grahamshaw1972/a2000Serotina/README.md

# A2000 Serotina Mechanical Keyboard

The A2000 Serotina Keyboard is a build it yourself Open Source Hardware Mechanical Keyboard for the Amiga A2000 and A3000 computers. Features are:

- Uses standard PC keyboard parts, case + keycaps

- Allows the use of the WASD keycap printing service for Amiga specific keycaps

- All soldering is Through Hole - no SMD soldering required

- No original A2000 keyboard parts required

- All electronic components are still available to buy

- Uses an Arduino micro-controller

- Uses Cherry MX type switches

- Uses QMK firmware ( with Amiga specific code added )

- Multiple QMK keymaps supported for regional key variations

- Plugs directly in to an A2000 or A3000 using the 5 pin Din connector - no USB required

Jan Beta has done an excellent build video for this keyboard. Please take a look:
https://youtu.be/dw3RDYq1Pn0?si=XJSP298tZxawzPFw

The keyboard layout for the UK keymap looks like this: 

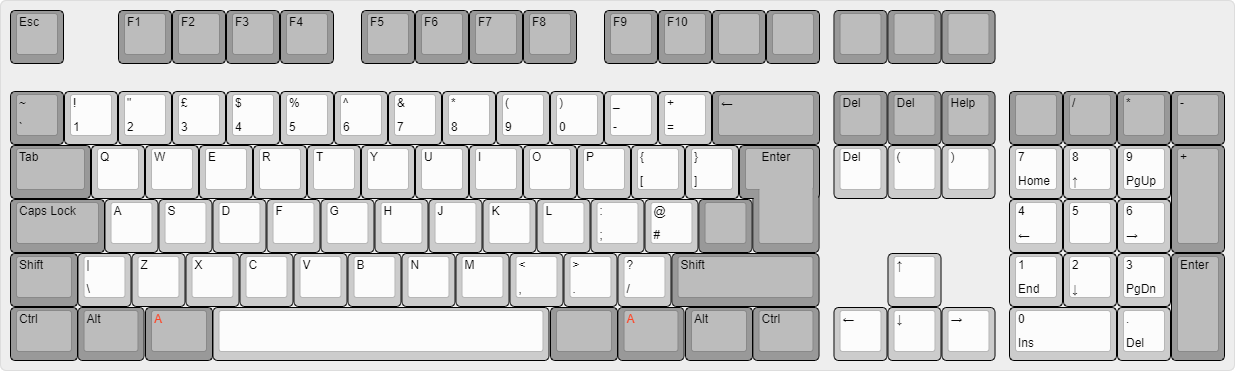
[picture p1: keyboardLayoutEditor/uk/a2000serotina_uk.png]


The PCB for V1.5 looks like this: 

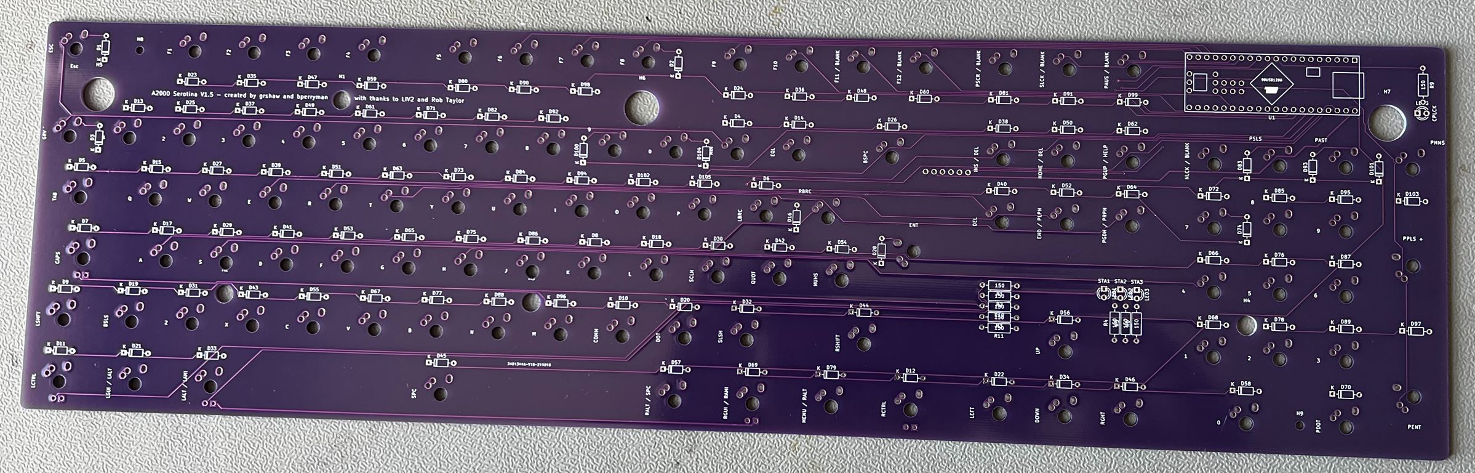
[picture p2: v1_5_pcb.JPG]


When the build is completed, V1.4 looks like this: 

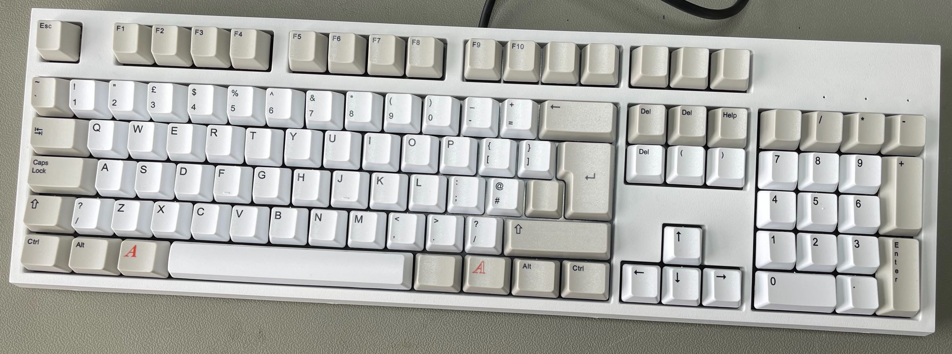
[picture p3: v1_4_complete.JPG]


A family portrait. The V1.4 Serotina keyboard with it's bigger brother and the inspiration for the project. 

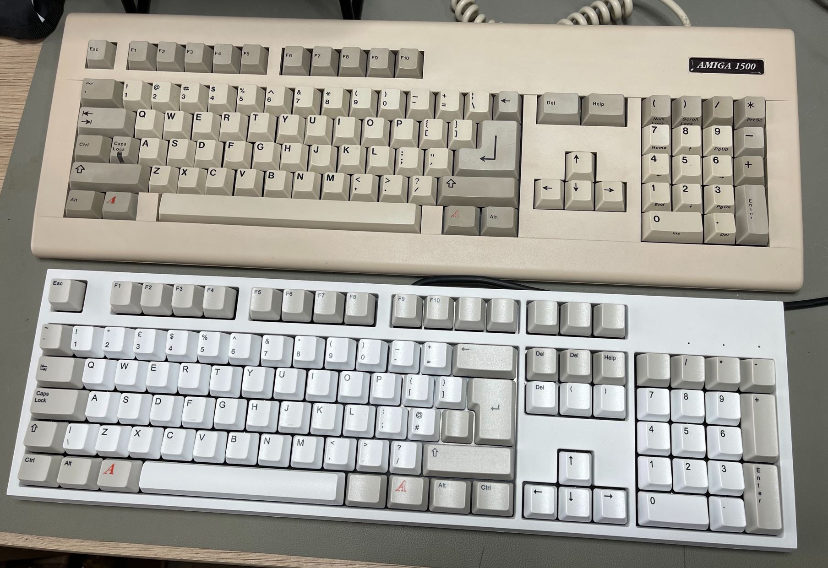
[picture p4: v1_4_familyPortrait.JPG]
