grahamshaw1972/a2000Serotina/keyboardLayoutEditor/iso105UkWithSwitchNumbers.png

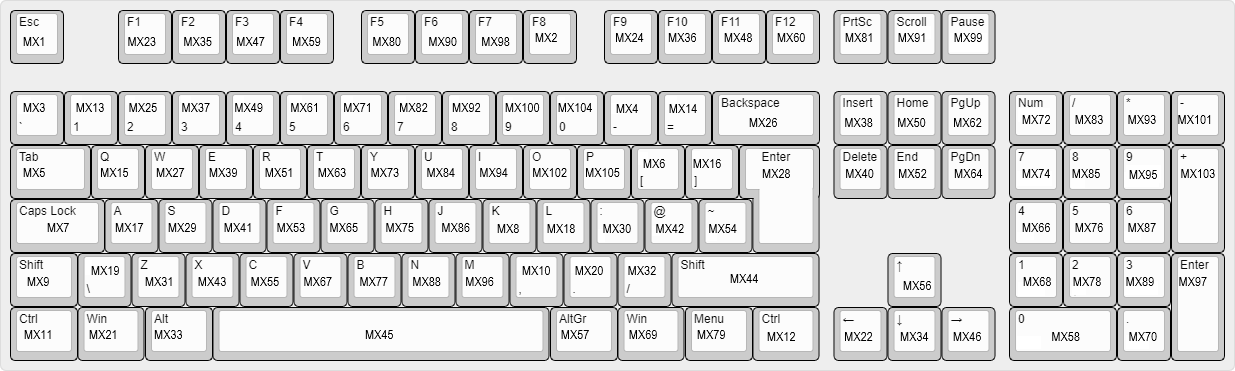
keyboardLayoutEditor/iso105UkWithSwitchNumbers.png
