grahamshaw1972/a2000Serotina/pcbV1_0.PNG

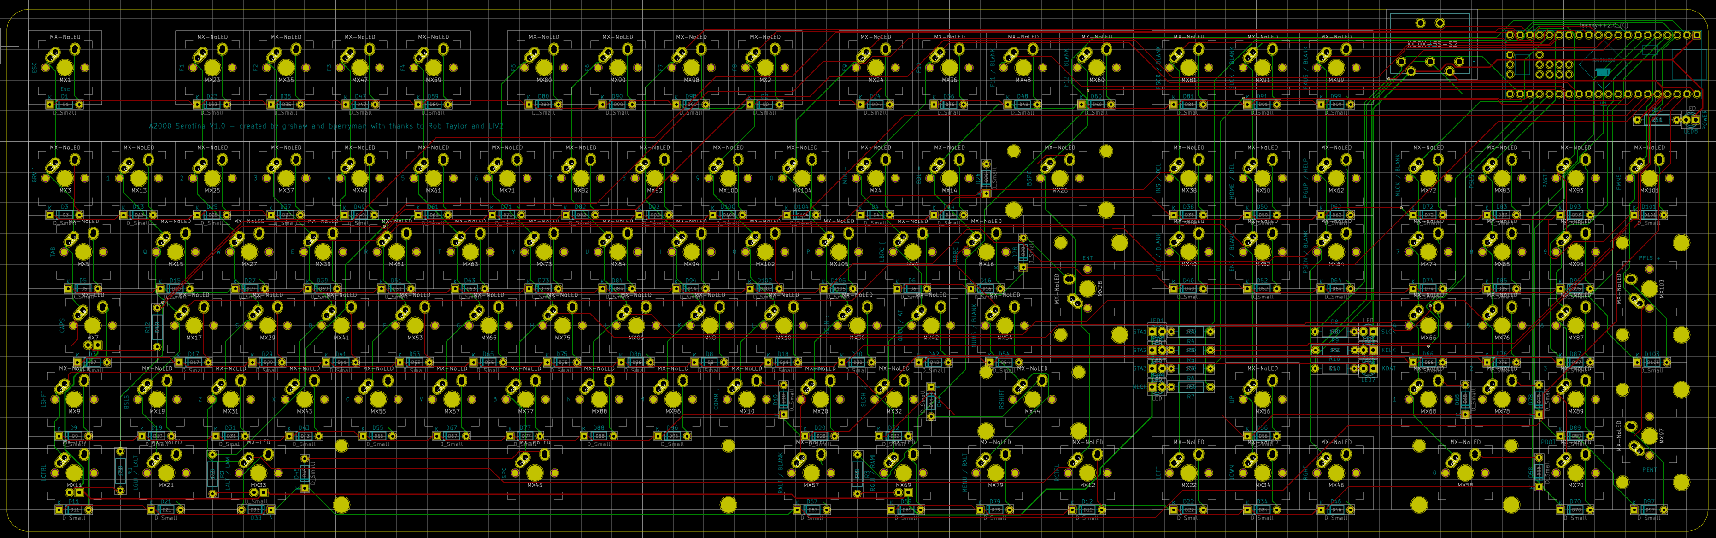
pcbV1_0.PNG
