grahamshaw1972/a2000Serotina/renderV1_0.png

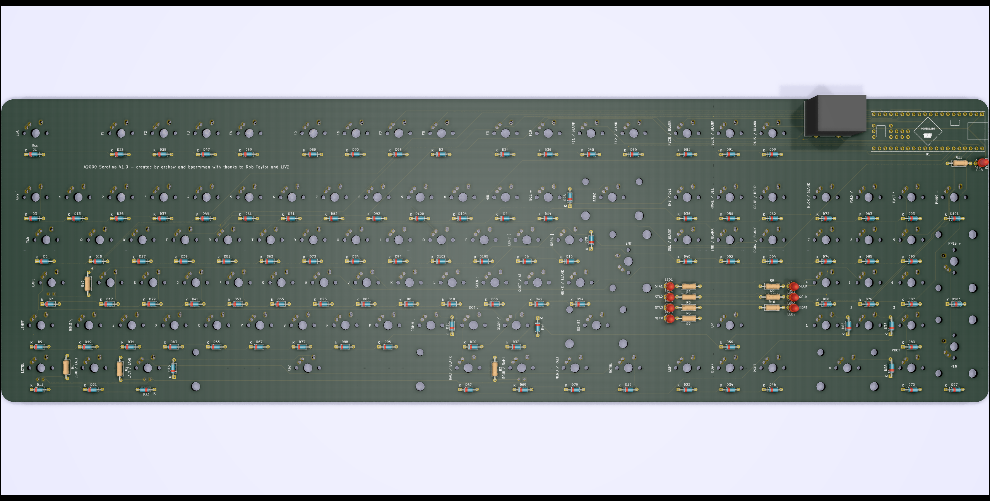
renderV1_0.png
