grahamshaw1972/a2000Serotina/v1_4_pcb.JPG

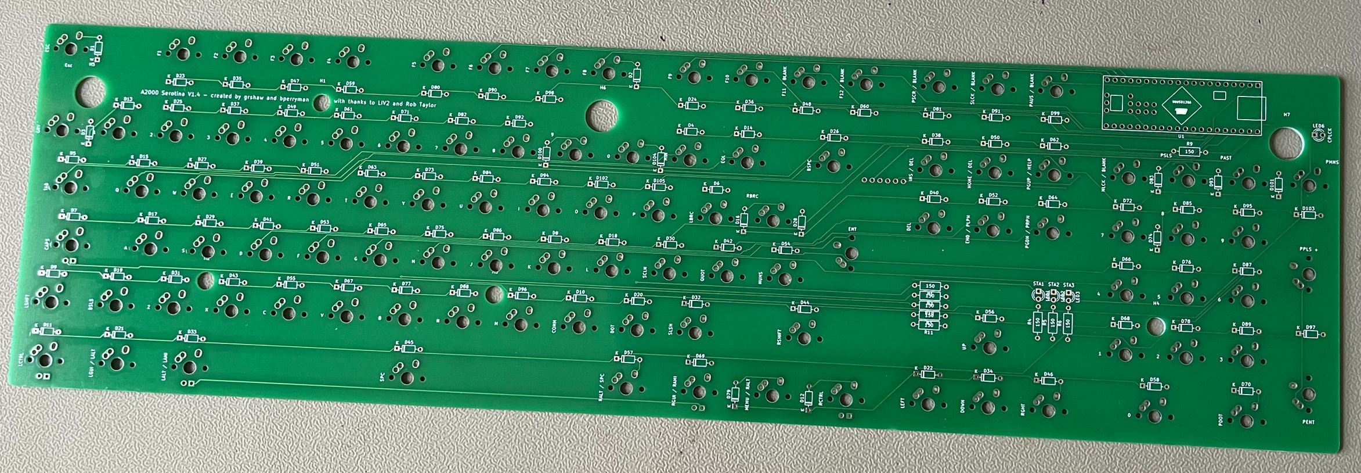
v1_4_pcb.JPG
