grahamshaw1972/a2000Serotina/bom/a2000Serotina.xlsx

Sheet: Mouser
Quantity | Mouser Part Number | References | Value | Footprint
9 | 603-CFR-25JR-52150R | R1 - R6, R9, R10 + R11 | 150 | R_Axial_DIN0207_L6.3mm_D2.5mm_P7.62mm_Horizontal
105 | 512-1N4148 | D1 - D105 | Switching Diode | D_DO-35_SOD27_P7.62mm_Horizontal
1 | 474-DEV-11781 | U1 | Teensy++ 2.0 | D_DO-35_SOD27_P7.62mm_Horizontal
9 | 78-TLHK42T1U2 | LED1 - LED3, LED6, MX7, MX11, MX12, MX33 + MX69 | Red LED | LED_D3.0mm
105 | 540-MX1A-11NW | MX1 - MX105 | Cherry MX Black | L15.6 mm_W15.6 mm
1 | 538-90121-0766 | J1 | Right Angle Pin Header | 6_ 2.54 mm_1_row

Sheet: Other Sources
Quantity | Supplier | URL | References | Value | Footprint | Notes
1 | Amazon | https://amazon.co.uk/gp/product/B07K8FFDYJ/ref=ppx_yo_dt_b_asin_title_o01_s00?ie=UTF8&psc=1 | MX44, MX26, MX28, MX58, MX97, MX103 + MX45 | Costar Stabilizers | 7 x 2u + 1 x 6.25u | Only need 6 x 2u, one is spare
1 | Hobby Components | https://hobbycomponents.com/connectors/439-01-254mm-40way-sil-turned-pin-m-m-headers-pack-of-5 | U1 | 40 pin | 2 x 20 pin | Cut in half
1 | WASD | https://www.wasdkeyboards.com/wasd-v3-104-key-or-105-key-diy-kit.html |  | Case, Steel Mounting Plate | 105-Key ISO
1 | WASD | https://www.wasdkeyboards.com/105-key-iso-custom-cherry-mx-keycap-set.html |  | Keycaps | 105-Key ISO | https://github.com/grahamshaw1972/a2000Serotina/tree/main/orderingKeycaps
1 | Amazon | https://amazon.co.uk/dp/B00KEW1YZE/ref=cm_sw_em_r_mt_dp_1WGQXR1D324A5GNPR9FJ?_encoding=UTF8&psc=1 | J1 |  | 5 Pin DIN Cable | Cut in half
1 | Amazon | https://www.amazon.co.uk/gp/product/B07QNPZDTW/ref=ppx_yo_dt_b_asin_title_o07_s00?ie=UTF8&psc=1 | J1 |  |  | Dupont Crimping Kit

Sheet: Other Switch options
Notes On Switches
The Original A2000 Cherry Keyboard uses Cherry MX switches. These have since become the most common switch used in Mechanical Keyboards. Most Cherry MX switches come in two different varieties, Plate mount and PCB mount. We need Plate mount for this project*. That still leaves a very wide field of switches available Which switch you choose therefore comes down to personal choice.
If you choose to try and re-create the feel of the Original A2000 Cherry Keyboard, then I can provide some recommendations. The keyboard came with Cherry MX Black switches. These are one of the earliest MX switches which Cherry made. Cherry MX Black switches have changed somewhat over the years. Not in design, but in materials. Many consider that the Cherry MX Black switches of today are not as smooth feeling as those of 30 years ago. 30 year old Cherry MX Black switches are now known as Vintage Blacks to make it possible to distinguish between the two and they are quite sought after. This means that just buying Cherry MX Blacks may not re-create the original feel of the keyboard as you may expect. It's certainly an option that should be considered though. You can also buy them from Mouser, along with the other components
URL | Notes | Cost for 105 switches
https://www.mouser.co.uk/ProductDetail/CHERRY/MX1A-11NW | Modern Cherry MX Black Switches. Probably cheaper from other suppliers | USD 72.45
https://novelkeys.com/collections/switches/products/gateron-switches-1 | Gateron Switches. Cheaper and most agree that they feel very similar Cherry. I used Yellow in my first build. Slightly lighter than black but still have a retro feel. | USD 26.00
https://novelkeys.com/collections/switches/products/nk_-cream-series?variant=40598616866983 | NovelKeys Cream switches. A Linear switch with a very smooth feel, similar weight to Vintage Cherry MX Blacks | USD 70.20
https://novelkeys.com/collections/switches/products/gateron-ink-switches | Gateron Ink Switches. A Linear switch with a smooth feel. I plan to use Ink Yellows for my second build | USD 82.00
NB - there are many mecanical keyboard suppliers around the world. It would probably make sense to order from one in your own country if you are able to find one.
*You can convert PCB mount switches into Plate mount switches by clipping off the plastic mounting lugs with side cutters
