grahamshaw1972/a2000Serotina/buildCompleteV1_2.jpg

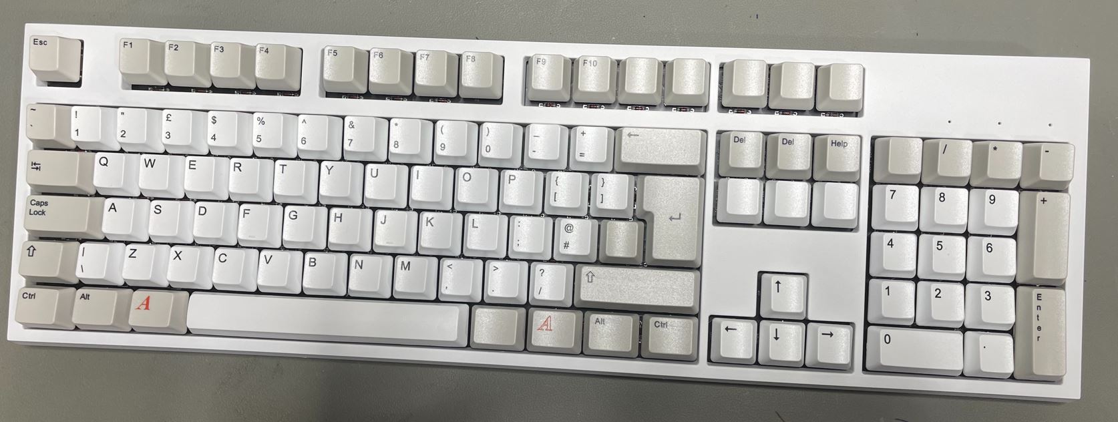
buildCompleteV1_2.jpg
