grahamshaw1972/a2000Serotina/buildInstructions/connected.JPG

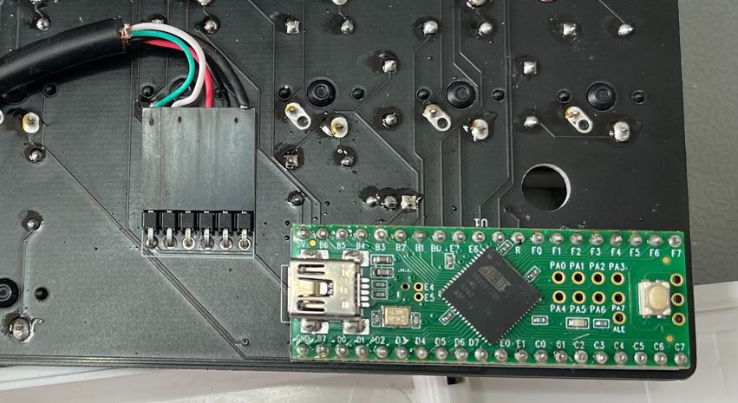
buildInstructions/connected.JPG
