grahamshaw1972/a2000Serotina/buildInstructions/inBottomCase.JPG

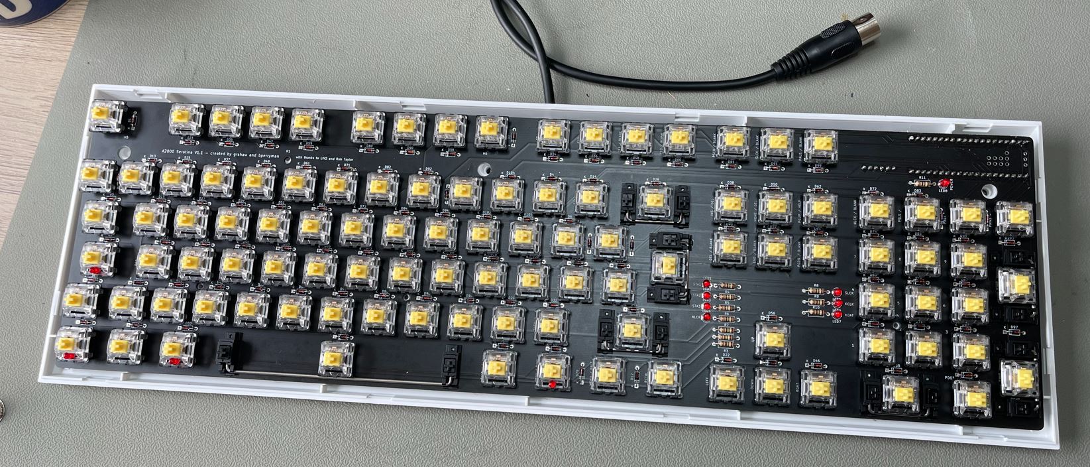
buildInstructions/inBottomCase.JPG
