grahamshaw1972/a2000Serotina/buildInstructions/screwed.JPG

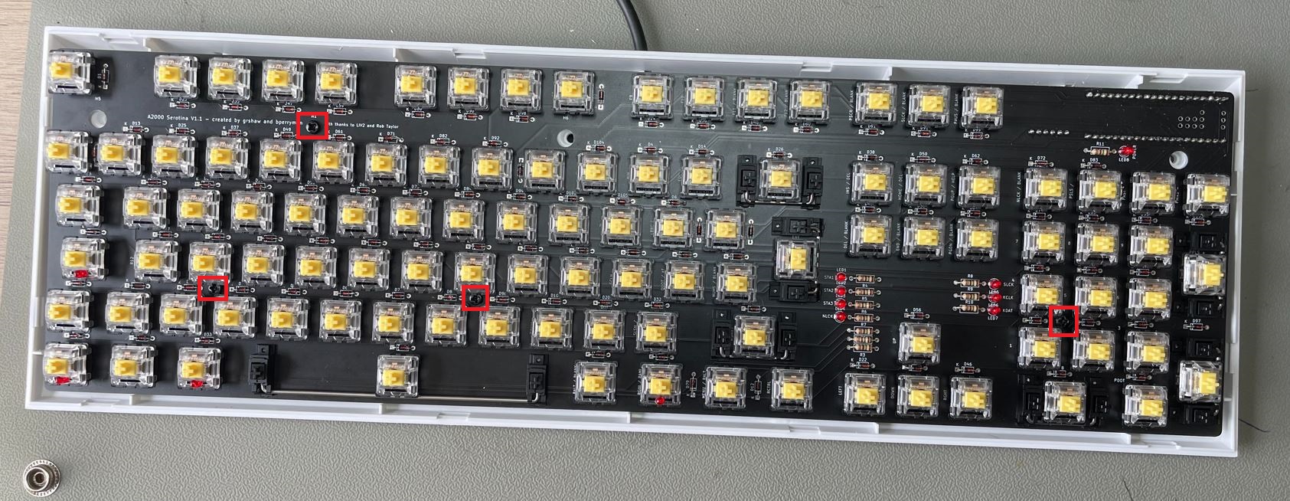
buildInstructions/screwed.JPG
