grahamshaw1972/a2000Serotina/keyboardFirmwareBuilder/iso105Uk.png

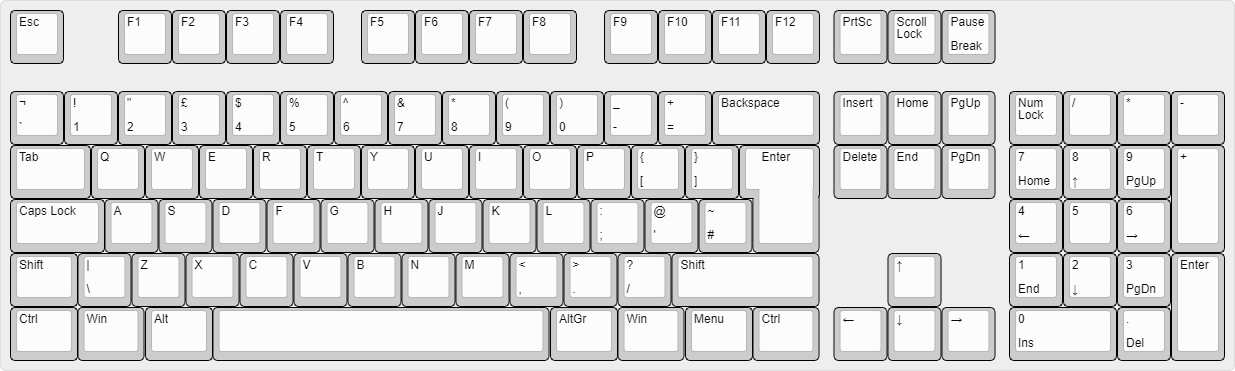
keyboardFirmwareBuilder/iso105Uk.png
