grahamshaw1972/a2000Serotina/keyboardFirmwareBuilder/pins.PNG

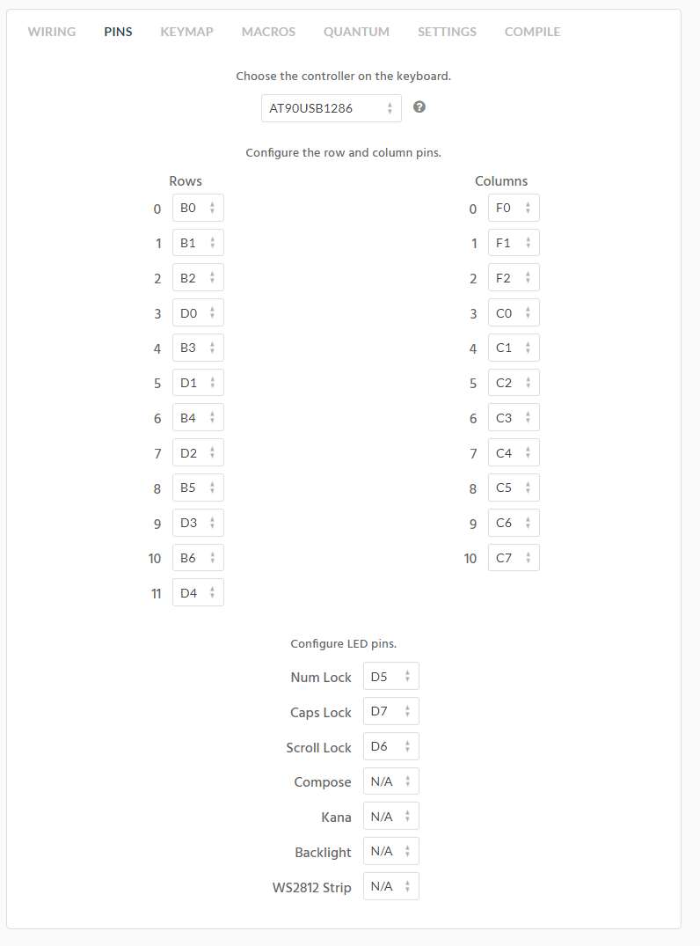
keyboardFirmwareBuilder/pins.PNG
