grahamshaw1972/a2000Serotina/keyboardFirmwareBuilder/wiring.PNG

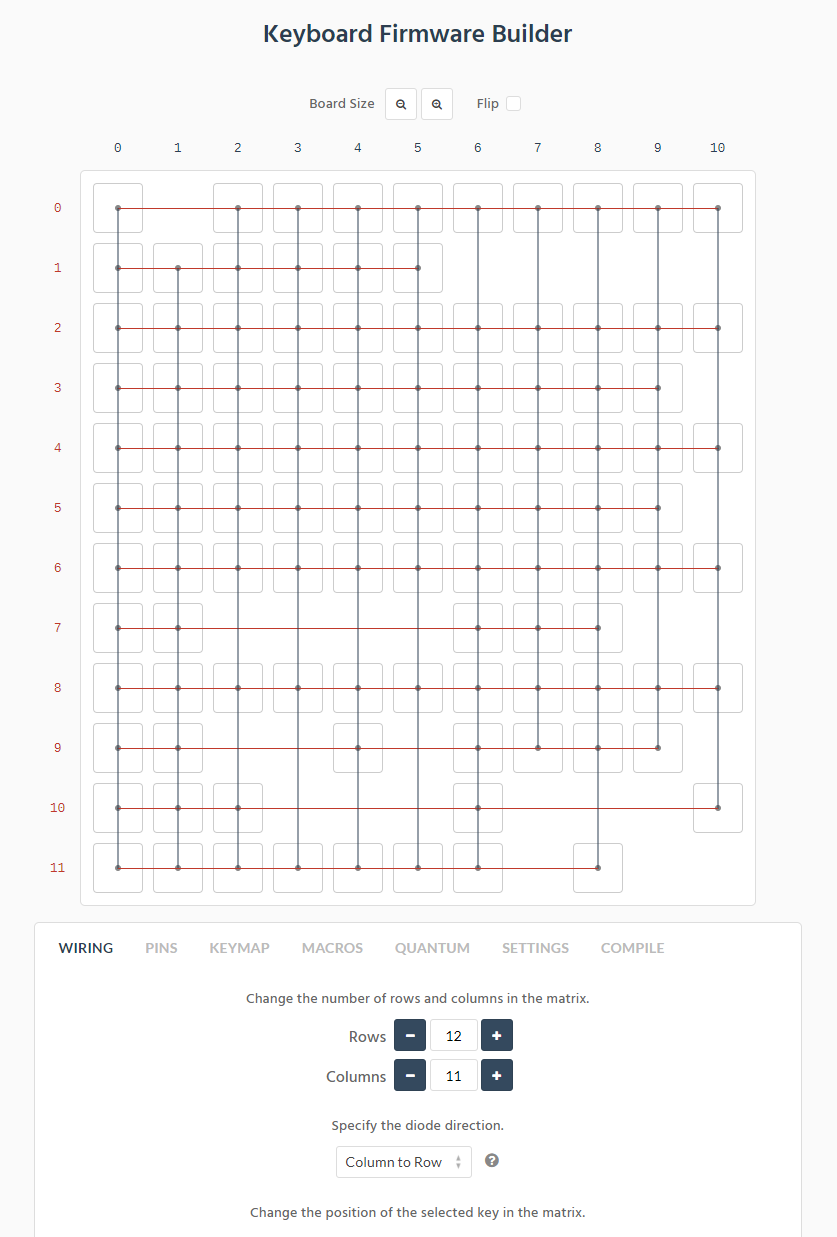
keyboardFirmwareBuilder/wiring.PNG
