grahamshaw1972/a2000Serotina/keyboardLayoutEditor/a2000serotinawiring.png

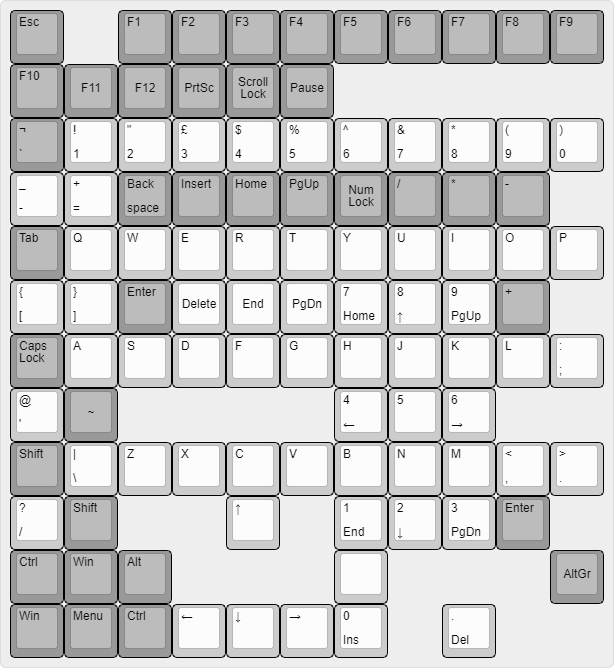
keyboardLayoutEditor/a2000serotinawiring.png
