grahamshaw1972/a2000Serotina/(threads)

Thread 1 (2023-11-25):

WASD Keyboard kit is discontinued

grahamshaw1972, 2023-11-25:
The project uses a WASD Keyboard kit. This provides both the mounting plate and the case. If anyone knows of a different source for a full size mounting plate and case then please let me know.

arnljot, 2025-02-06:
Full size keyboard cases are a pita to source.

The WASD kit case is sourced from Costar, it's their [CST-104-SYDNEY](https://costar.com.tw/2022/03/08/cst-104-sydney/) white label kit.

Previous keyboards are the "Thermaltake Meka G1" and the "Rosewill RK-9000".

Today British Filco uses their keyboard cases in a modified version. American [Mechanicalkeyboards.com](https://mechanicalkeyboards.com/products/filco-convertible-italian-red-kobo-frame?_pos=12&_fid=643388fbb&_ss=c) sells them without a Filco keyboard, unlike Thekeyboardcompany who require you to buy a keyboard before you can buy the case you like.

grahamshaw1972, 2025-02-06:
That's really useful information. Thank you.

arnljot, 2025-02-08:
Looks like the [Vortex Multix 104 VIA](https://vortexgear.store/products/multix-104-via) barebone kit might be using the same case, only with an engraved Vortex logo text.

I've ordered one so I can take measurements of the PCB it comes with.

arnljot, 2025-02-20:
@grahamshaw1972, I've got the Vortex Multix 104 VIA ISO (VT-1000)  in my hands now. I'll make some measurements on the key positions. If they match I'll press forward and measure the PCB.

The case is snap fit together plastic, very tight and hard so there's a real chance to break it trying to open it.

Do you have any suggestions as to which measurements that will give the best "smoke test" to see if there's any point in opening up?

Thread 2 (2025-02-07):

Teensy2.0++ (AT90USB1286) in BOM is discontinued

arnljot, 2025-02-07:
What is the suitable replacement part?

grahamshaw1972, 2025-02-21:
Hi there, I am not aware of any suitable replacements that are still available unfortunately. If anyone knows of a replacement, please post a comment here.
