grahamshaw1972/a2000Serotina/qmk_firmware/keyboards/a2000Serotina/config.h

/* Copyright 2021 REPLACE_WITH_YOUR_NAME
 *
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
 * You should have received a copy of the GNU General Public License
 * along with this program.  If not, see <http://www.gnu.org/licenses/>.
 */

#pragma once

#include "config_common.h"

/* USB Device descriptor parameter */
#define VENDOR_ID       0xFEED
#define PRODUCT_ID      0x0000
#define DEVICE_VER      0x0001
#define MANUFACTURER    %MANUFACTURER%
#define PRODUCT         a2000Serotina

/* key matrix size */
#define MATRIX_ROWS 12
#define MATRIX_COLS 11

/*
#define MATRIX_ROWS 5
#define MATRIX_COLS 4
*/

/*
 * Keyboard Matrix Assignments
 *
 * Change this to how you wired your keyboard
 * COLS: AVR pins used for columns, left to right
 * ROWS: AVR pins used for rows, top to bottom
 * DIODE_DIRECTION: COL2ROW = COL = Anode (+), ROW = Cathode (-, marked on diode)
 *                  ROW2COL = ROW = Anode (+), COL = Cathode (-, marked on diode)
 *
 */
#define MATRIX_ROW_PINS { B0, B1, B2, D0, B3, D1, B4, D2, B5, D3, B6, D4 }
#define MATRIX_COL_PINS { F0, F1, F2, C0, C1, C2, C3, C4, C5, C6, C7 }
/*
#define MATRIX_ROW_PINS { D0, D1, D2, D3, D4 }
#define MATRIX_COL_PINS { C0, C1, C2, C3 }
*/

#define DIODE_DIRECTION COL2ROW
#define NO_USB_STARTUP_CHECK 1

#define LED_NUM_LOCK_PIN D5
#define LED_CAPS_LOCK_PIN D7
#define LED_SCROLL_LOCK_PIN D6

// generated by KBFirmware JSON to QMK Parser
// https://noroadsleft.github.io/kbf_qmk_converter/
