grahamshaw1972/a2000Serotina/(commit log)

2021-07-04 Create Kicad project
    [a2000Serotina.kicad_pcb, a2000Serotina.sch]
2021-07-04 Add Kicad Symbol & Footprint libraries.
2021-07-04 Add submodules teensy_library and teensy.pretty
2021-07-04 Add teensy kicad lib
2021-07-04 Add Footprints and layouts for Samacsys Library Loader
    This allows ECAD models to be downloaded directly from Mouser.
2021-07-04 Wiring planned out.
    Used Keyboard Firmware Builder to design Wiring layout.
    Added various design files for wiring layout.
    Also added a2000serotina.zip which contain QMK firmware ( needs to be updated )
2021-07-04 Some work on the Schema
    [a2000Serotina.sch]
2021-07-05 Further work on Keyboard Matrix
    [a2000Serotina.sch]
2021-07-06 Matrix now complete.
    [a2000Serotina.sch]
2021-07-07 Connections and wiring complete
    Now working on PCB Footprints.
    [a2000Serotina.sch, switchFootprints.xlsx]
2021-07-08 All footprints now assigned
    [a2000Serotina.sch, switchFootprints.xlsx]
2021-07-08 Work on PCB Layout
    [a2000Serotina.sch, switchFootprints.xlsx]
2021-07-08 All switches now placed.
    [a2000Serotina.kicad_pcb, a2000Serotina.sch]
2021-07-08 All Components now placed on PCB
    [a2000Serotina.kicad_pcb]
2021-07-09 Auto routing complete
    [a2000Serotina.kicad_pcb]
2021-07-09 Add picture of the PCB to README.md
2021-07-09 Update pcbV1_0.PNG
    Increased resolution of PCB image
2021-07-09 Fix PCB layout
    Move Diodes that are too close to Stabilizer drill holes.
    [a2000Serotina.kicad_pcb, switchFootprints.xlsx]
2021-07-10 Generated Gerber Files and Bill of Materials
    [a2000Serotina.kicad_pcb, a2000SerotinaBOM.xlsx]
2021-07-10 Added Text Labels to Front Silkscreen
    Added letter labels for Mx Switches
    Added labels for LEDs
    Sorted out Resistor footprints so that vaules are visible on Front Silkscreen.
    [a2000Serotina.kicad_pcb, a2000Serotina.xlsx, a2000SerotinaBOM.xlsx]
2021-07-11 Update to PCB
    Moved DIN socket and CPU nearer to edge of PCB.
    [a2000Serotina.kicad_pcb]
2021-07-11 Added qmk_firmware
    [nose2.cfg]
2021-07-11 Use TeensyNumPad config in firmware
2021-07-11 Change Row 6 Pin from D6 to F2
    D6 lights the LED on the Teensy 2.0 ++ - better to have D6 control a LED.
    [a2000Serotina.kicad_pcb, a2000Serotina.sch]
2021-07-14 Updated column / row layout of switches
    Now much more regular on the bottom rows.
    [a2000Serotina.kicad_pcb, a2000Serotina.sch, switchFootprints.xlsx, switchLayout2.xlsx]
2021-07-21 Updated readme with picture of the real PCB
2021-07-25 V1.0 Build and Bug fixes following fault finding
    [switchLayout2.xlsx]
2021-07-28 Add Definitions for LED pins
    In config.h:
    #define LED_NUM_LOCK_PIN D5
    #define LED_CAPS_LOCK_PIN D7
    #define LED_SCROLL_LOCK_PIN D6
    Also light LEDS STA1 + STA2 if 2 or 3 keys are pressed simulaneously.
2021-07-29 Add signature lighting of Amiga key LEDS
    Light LEDS in keys when each of the Amiga Reset keys is pressed.
    LCTRL, LAMI, RAMI on the Amiga keyboard.
    Which maps to LCTRL, LALT, RGUI on the PC keyboard.
    [a2000Serotina.c]
2021-08-01 Reset Amiga now working.
    [a2000Serotina.c, a2000Serotina.h]
2021-08-01 Add Mounting holes
    [a2000Serotina.kicad_pcb, a2000Serotina.sch]
2021-08-03 Change 5 Pin Din to right angle pin headers
    So that a case will fit on.
    [a2000Serotina.kicad_pcb, a2000Serotina.sch]
2021-08-04 Move and rotate right angle pin header
    [a2000Serotina.kicad_pcb]
2021-08-08 Fixes to firmware
    1) Fix bug where Pressing Enter and small Enter together causes lock up. In fact pressing any two keys mapped to the same Amiga keys was causing a problem. Now fixed
    2) Disable Caps Lock on Amiga. This was causing odd behaviour. Notes on the behaviour are:
    Caps Lock -> an alpha character, results in q bogus character being repeated e.g
    a 0x20 -> q 0x10
    s 0x21 -> nothing
    d 0x22 -> w 0x11
    f 0x23 -> nothing
    g 0x24 -> e 0x12
    h 0x25 -> nothing
    j 0x26 -> r 0x13
    q 0x10 10000 -> 8 0x08 01000
    w 0x11 -> nothing
    e 0x12 10010 -> 9 0x09 01001
    r 0x13 -> nothing
    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
    [a2000Serotina.c, a2000Serotina.h]
2021-08-08 Add Support for US Layout.
    Add Support for US Layout.
    Also fix bug where P0 was being ignored on Amiga:
    if(keycode != AKC_CAPS) -> if(amigaKeyCode != AKC_CAPS)
    AKC_CAPS is 0x62, QMK key for code 0x62 is P0. So code was previously ignoring P0, not Caps Lock at all.
    [a2000Serotina.c]
2021-08-17 Update firmware to flash all LEDs on start up
    Flash all LEDs for 1s on start up.
2021-08-18 Updated PCB design, fitting into case
    1) Add extra CTRL_LED in Right Ctrl Key DONE
    2) Add extra CAPS_LED in top right LED6 R9 ( Previously KCLK ) DONE
    CAPS_LOCK NUM_LOCK SCR_LOCK
    3) Move NMLCK + SCLCK LEDs to top right DONE
    4) Fix font on second half of Thank you message DONE
    with thanks to LIV2 and Rob Taylor
    5) Update Amiga keys on silkscreen DONE
    6) Move R12 to be in line with all other resistors DONE
    7) Need to move D72 so that it doesn't contact J1 DONE
    8) Update Snip Silk screen DONE
    9) Move D3 - too close to MX Switch DONE
    10) Update firmware - add flash of all LEDs for 1.0s on start up... DONE
    12) Remove power LED DONE
    13) Remove KDAT + KCLK LEDS DONE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
    [a2000Serotina.kicad_pcb, a2000Serotina.sch]
2021-08-19 Update README.md, changing Build Complete Picture
    Change from V1.0 to V1.2 - now in case.
2021-08-20 Update Build Instructions
    Build instructions are now complete - using V1.1 PCB
2021-08-21 Fix Bug with duplicate keycodes when keys being released
    Also Simplify Caps Lock Pressed logic. Now uses mod 2.
    [a2000Serotina.c]
2021-08-30 V1.3 Design Complete
    [a2000Serotina.kicad_pcb]
2021-09-05 Change for V1.4
    Now uses a mounting plate from WASD.
    1) Adjust dimensions to match WASD PCB
    2) Make mounting holes bigger so that PCB sits lower
    3) Move resistors so that they are not under plate
    4) Move Caps Lock LED to rightmost and move Teensy back to top.
    5) J1 moved between Enter + Del
    6) Stabilizer holes deleted. Costar Stabilizers now attached to Plate.
    7) Minimize hole courtyards to pass Design Rules Check
    [a2000Serotina.kicad_pcb, a2000Serotina.sch]
2021-09-06 V1.5
    1) Remove PCB mount holes from switch footprints. DONE
    [a2000Serotina.kicad_pcb]
2021-09-13 Update Build instructions
    Now covers a build using the v1.4 PCB.
2021-09-19 Add a2000Serotina_pc_testing_uk.hex
    Also complete V1.4 Build instructions and update main README.md with V1.4 pictures.
    [a2000Serotina.kicad_pcb]
2021-09-25 Update Build and Flashing Firmware Instructions
    Adding Cross Links in each case.
2021-09-25 Update BOM sheet + Build Instructions
    [a2000Serotina.xlsx]
2021-09-25 Update Ordering from WASD instructions
    [a2000Serotina.xlsx]
2021-09-25 Add PCB Printing instructions.
2021-10-03 Add two additional mounting holes
    To match WASD PCB.
    [a2000Serotina.kicad_pcb, a2000Serotina.sch]
2021-10-24 Updated first half of Build instructions to v1.5
    V1.5 PCB complete.
2021-11-06 Remove Build Steps column from BOM sheet
    [a2000Serotina.xlsx]
2021-11-06 Update Build Instructions
    [a2000Serotina.xlsx]
